jpcanesin/logitech-g613-keycaps/keys/017_R2_Grave.FCStd

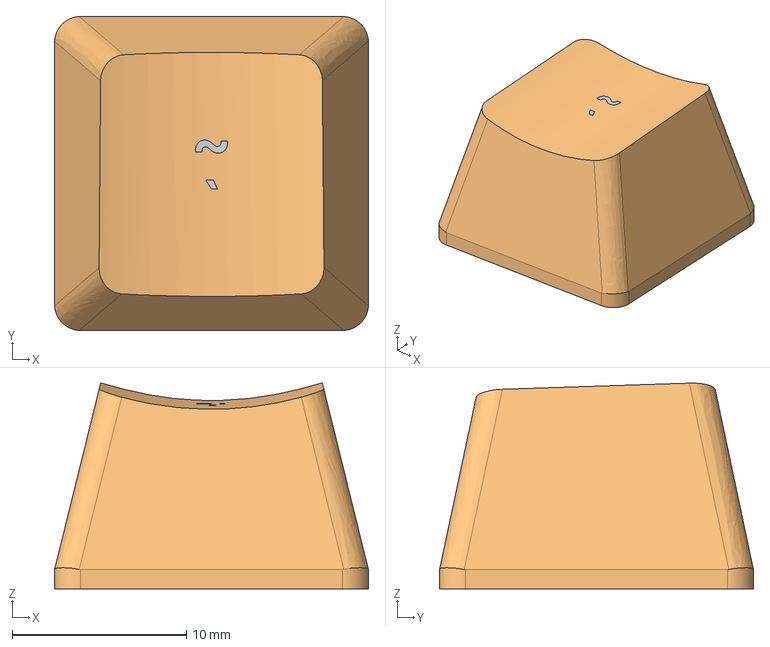
[picture p3: CAD file, 2026-10-18]
keys/017_R2_Grave.FCStd
18.0 x 18.0 x 11.8 mm
Inlay
Cap
