jpcanesin/logitech-g613-keycaps/shapes/R6-2.FCStd

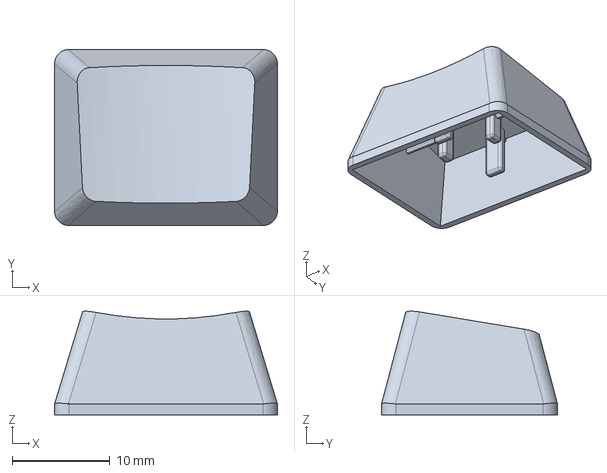
[picture p4: CAD file, 2026-10-18]
shapes/R6-2.FCStd
22.8 x 18.0 x 10.6 mm
