jpcanesin/logitech-g613-keycaps/keys/046_R3_I.FCStd

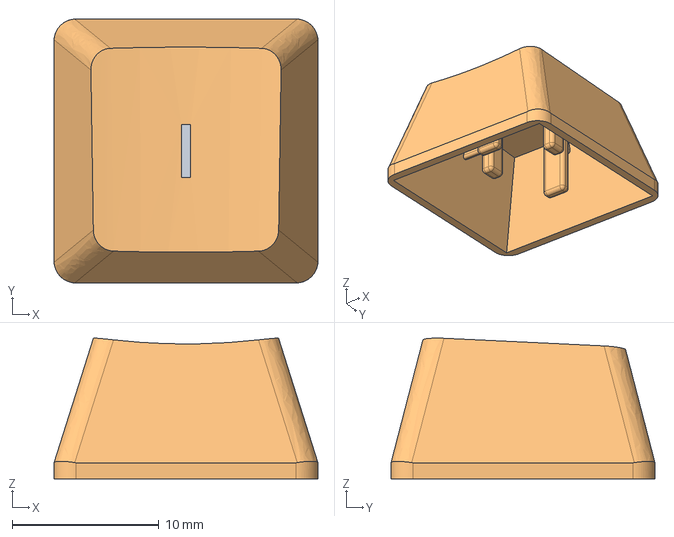
[picture p5: CAD file, 2026-10-18]
keys/046_R3_I.FCStd
18.0 x 18.0 x 9.60 mm
Inlay
Cap
