jpcanesin/logitech-g613-keycaps/shapes/NP-5.FCStd

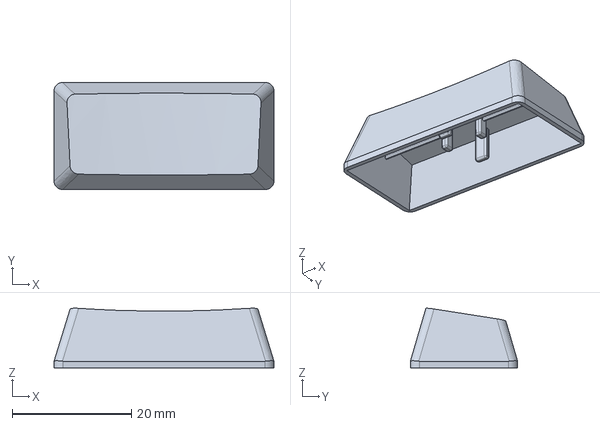
[picture p6: CAD file, 2026-10-18]
shapes/NP-5.FCStd
36.9 x 18.0 x 10.00 mm
