jpcanesin/logitech-g613-keycaps/shapes/NP-6.FCStd

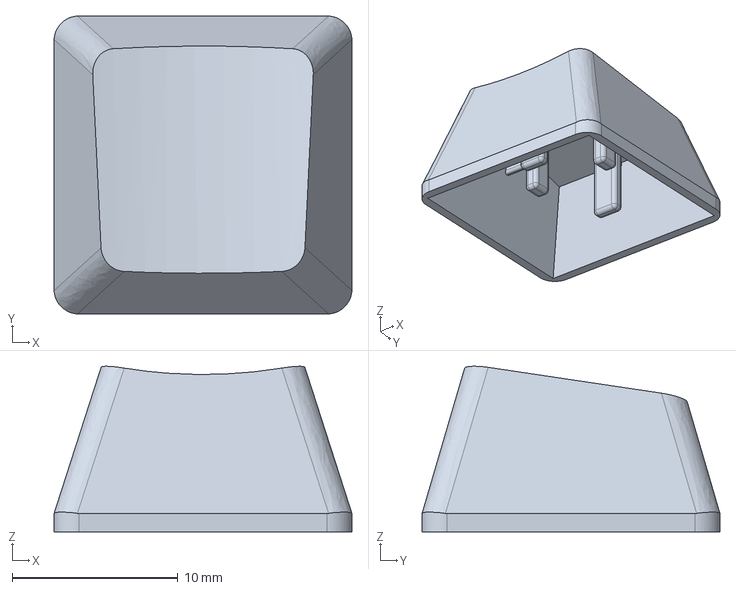
[picture p7: CAD file, 2026-10-18]
shapes/NP-6.FCStd
18.0 x 18.0 x 10.00 mm
