jpcanesin/logitech-g613-keycaps/shapes/R4-5.FCStd

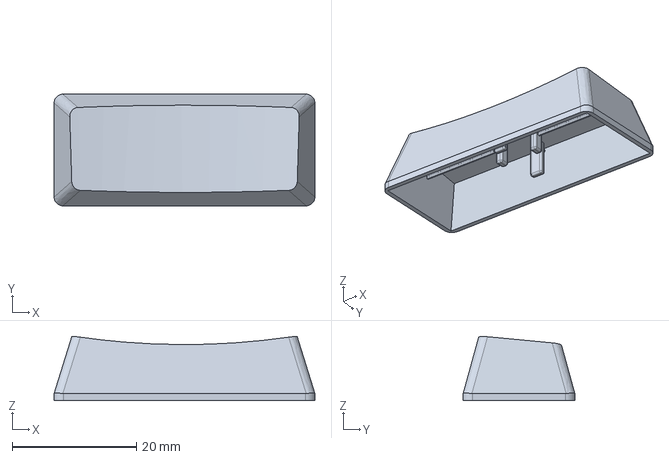
[picture p8: CAD file, 2026-10-18]
shapes/R4-5.FCStd
42.0 x 18.0 x 10.3 mm
