jpcanesin/logitech-g613-keycaps/keys/016_R1_Pause.FCStd

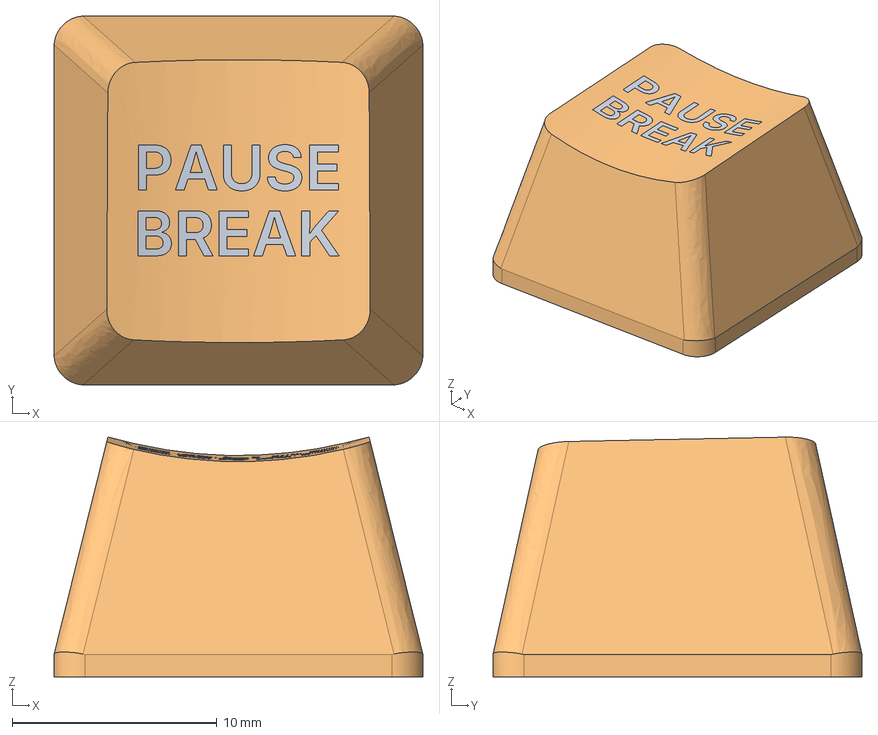
[picture p9: CAD file, 2026-10-18]
keys/016_R1_Pause.FCStd
18.0 x 18.0 x 11.7 mm
Inlay
Cap
