jpcanesin/logitech-g613-keycaps/keys/102_R6_ArrowRight.FCStd

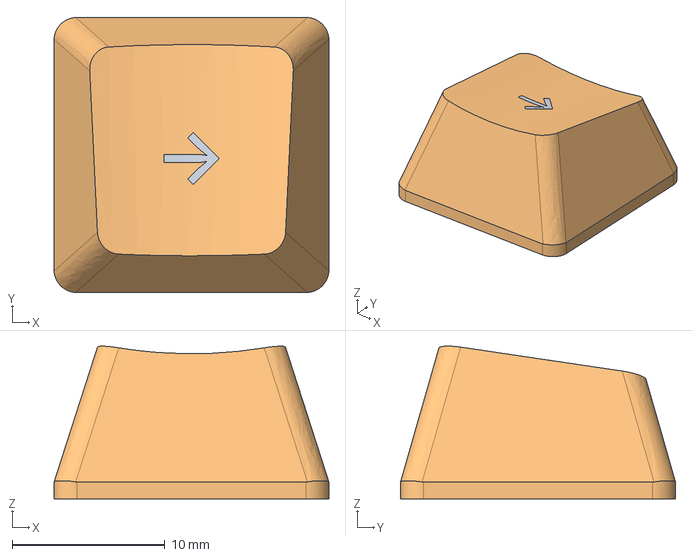
[picture p10: CAD file, 2026-10-18]
keys/102_R6_ArrowRight.FCStd
18.0 x 18.0 x 10.00 mm
Inlay
Cap
