jpcanesin/logitech-g613-keycaps/keys/097_R6_WinRight.FCStd

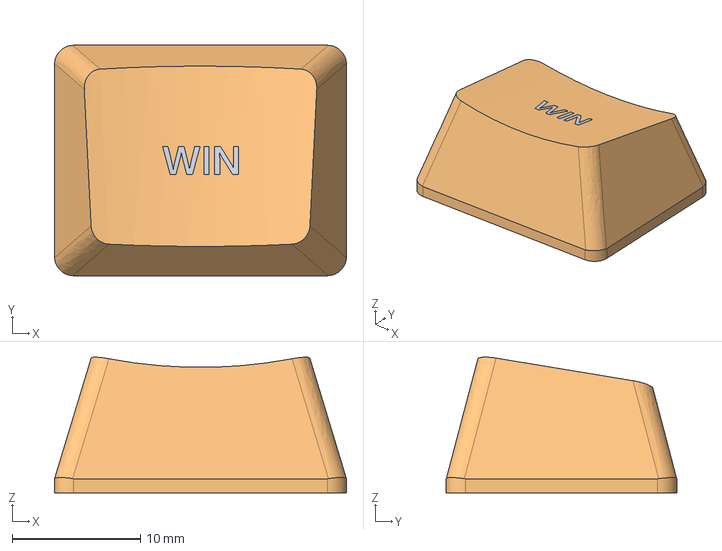
[picture p11: CAD file, 2026-10-18]
keys/097_R6_WinRight.FCStd
22.8 x 18.0 x 10.6 mm
Inlay
Cap
