jpcanesin/logitech-g613-keycaps/shapes/R6-1.FCStd

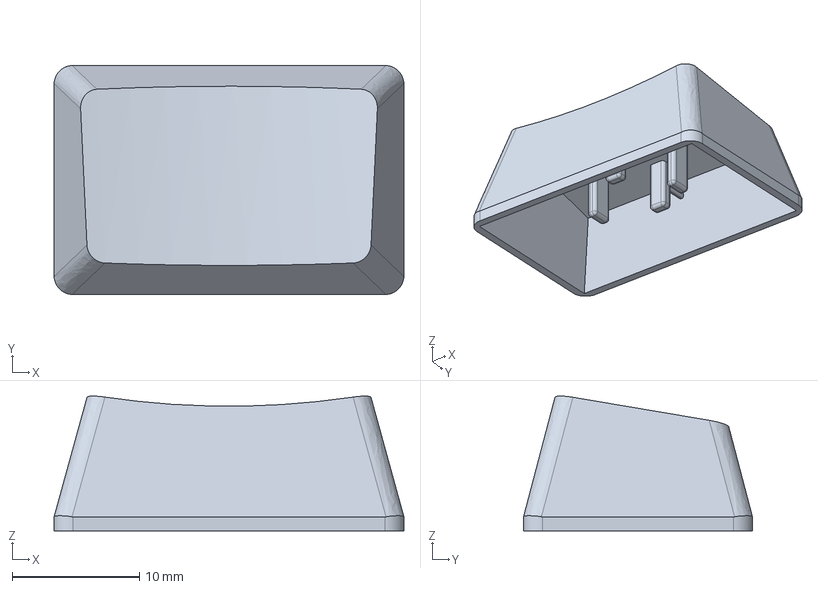
[picture p12: CAD file, 2026-10-18]
shapes/R6-1.FCStd
27.5 x 18.0 x 10.6 mm
