jpcanesin/logitech-g613-keycaps/shapes/R5-4.FCStd

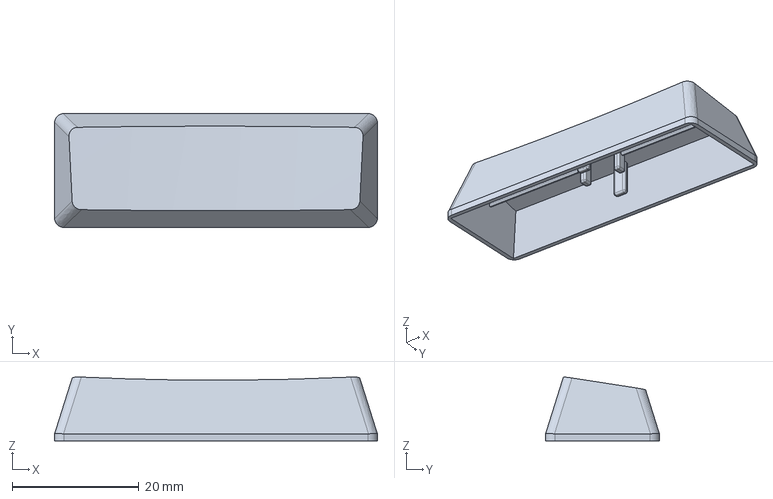
[picture p13: CAD file, 2026-10-18]
shapes/R5-4.FCStd
51.0 x 18.0 x 10.1 mm
