jpcanesin/logitech-g613-keycaps/keys/038_R3_Tab.FCStd

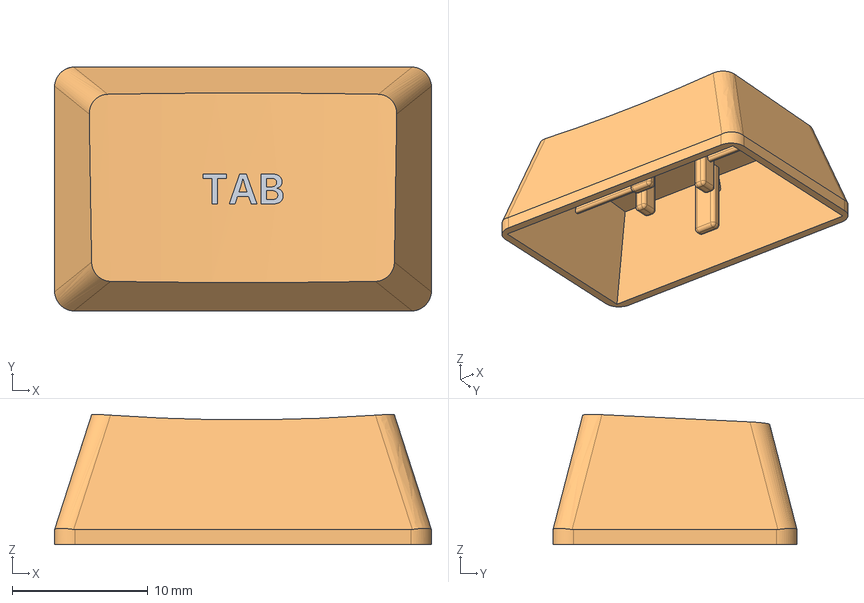
[picture p14: CAD file, 2026-10-18]
keys/038_R3_Tab.FCStd
27.8 x 18.0 x 9.60 mm
Inlay
Cap
