jpcanesin/logitech-g613-keycaps/shapes/R4-4.FCStd

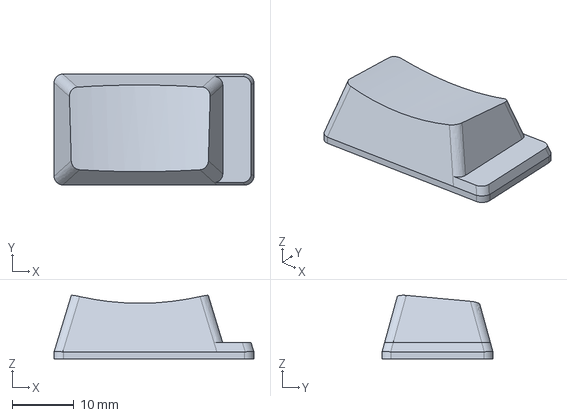
[picture p15: CAD file, 2026-10-18]
shapes/R4-4.FCStd
32.4 x 18.0 x 10.3 mm
