jpcanesin/logitech-g613-keycaps/keys/030_R2_Backspace.FCStd

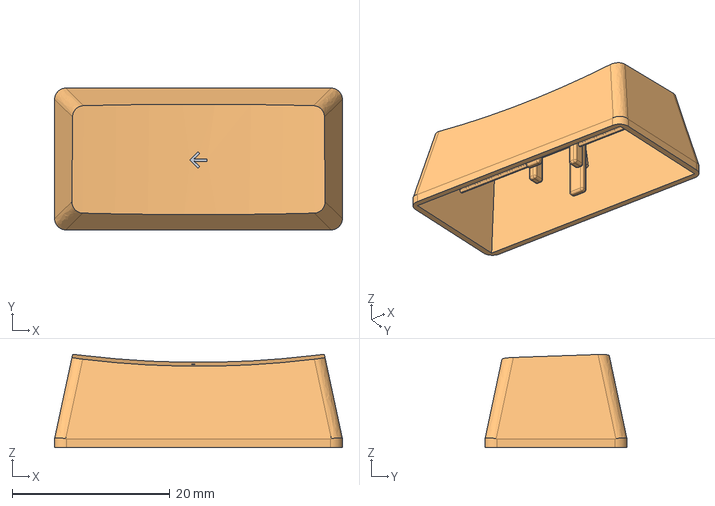
[picture p16: CAD file, 2026-10-18]
keys/030_R2_Backspace.FCStd
36.5 x 18.0 x 11.8 mm
Inlay
Cap
