jpcanesin/logitech-g613-keycaps/shapes/R6-4.FCStd

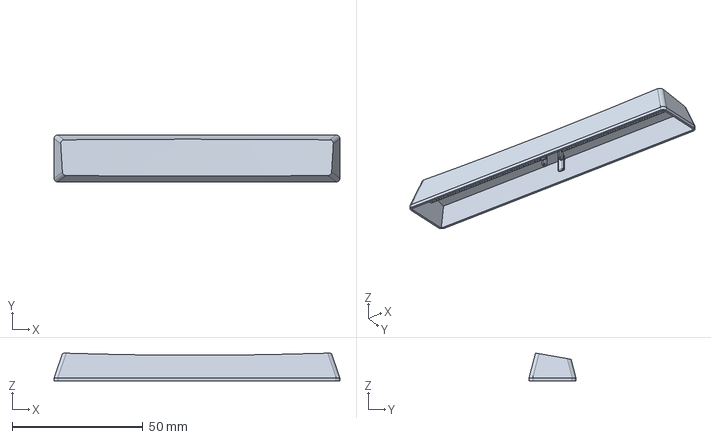
[picture p17: CAD file, 2026-10-18]
shapes/R6-4.FCStd
109.3 x 18.0 x 10.6 mm
