jpcanesin/logitech-g613-keycaps/shapes/NP-7.FCStd

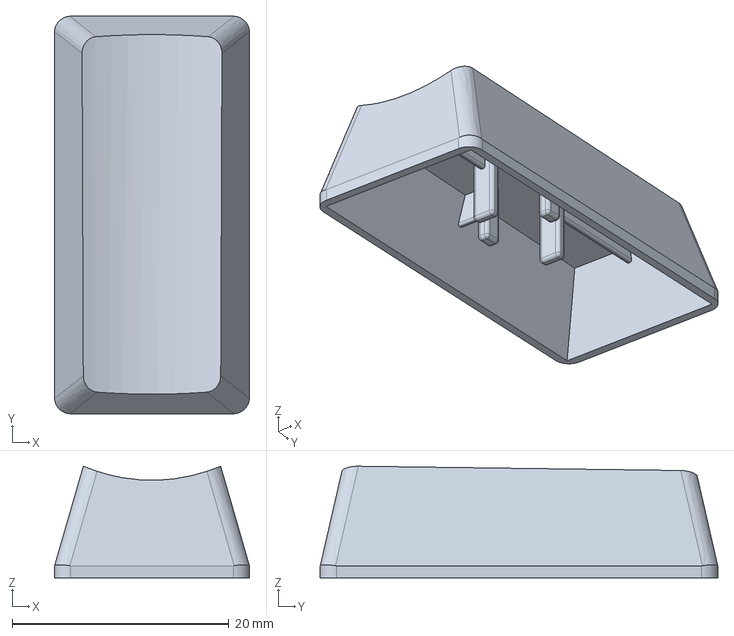
[picture p18: CAD file, 2026-10-18]
shapes/NP-7.FCStd
18.0 x 36.7 x 10.3 mm
