jpcanesin/logitech-g613-keycaps/keys/092_R6_CtrlLeft.FCStd

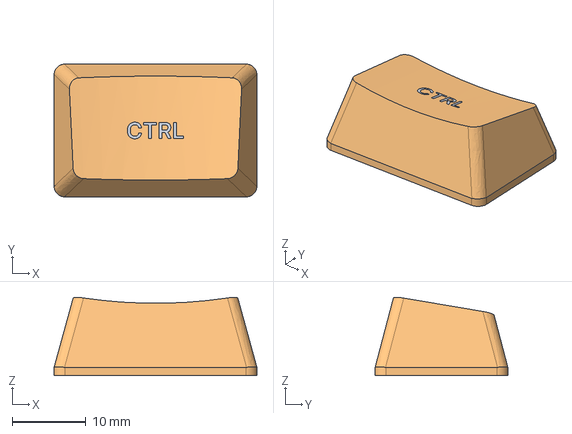
[picture p19: CAD file, 2026-10-18]
keys/092_R6_CtrlLeft.FCStd
27.5 x 18.0 x 10.6 mm
Inlay
Cap
