jpcanesin/logitech-g613-keycaps/keys/075_R5_ShiftLeft.FCStd

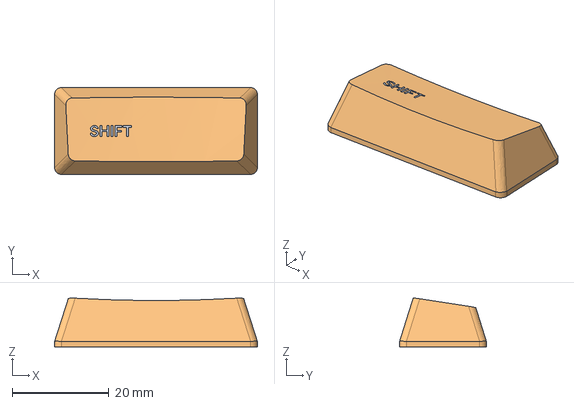
[picture p20: CAD file, 2026-10-18]
keys/075_R5_ShiftLeft.FCStd
42.0 x 18.0 x 10.1 mm
Inlay
Cap
