jpcanesin/logitech-g613-keycaps/keys/054_R3_PageDown.FCStd

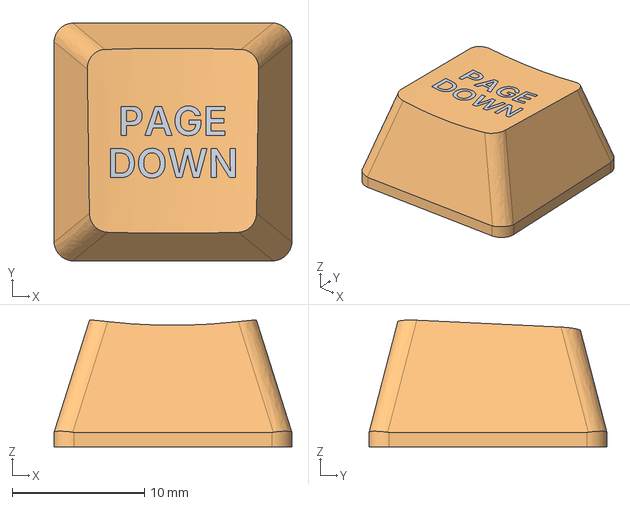
[picture p21: CAD file, 2026-10-18]
keys/054_R3_PageDown.FCStd
18.0 x 18.0 x 9.60 mm
Inlay
Cap
