jpcanesin/logitech-g613-keycaps/keys/059_R4_CapsLock.FCStd

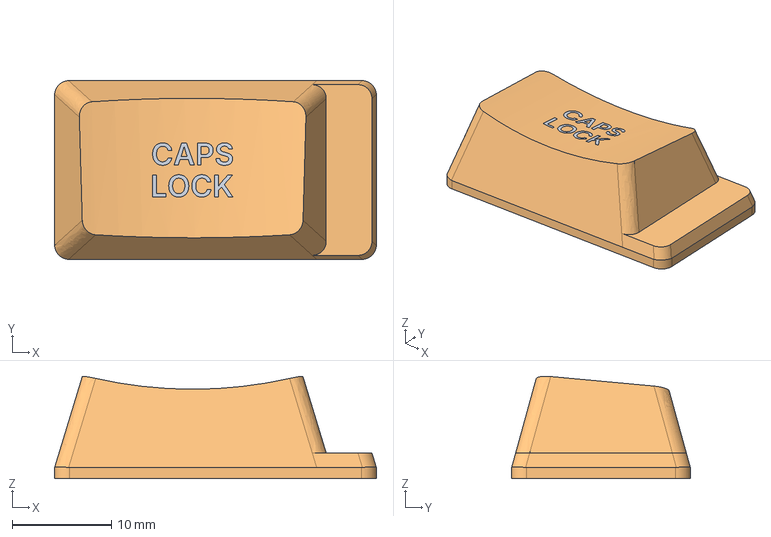
[picture p22: CAD file, 2026-10-18]
keys/059_R4_CapsLock.FCStd
32.4 x 18.0 x 10.3 mm
Inlay
Cap
