jpcanesin/logitech-g613-keycaps/keys/086_R5_ShiftRight.FCStd

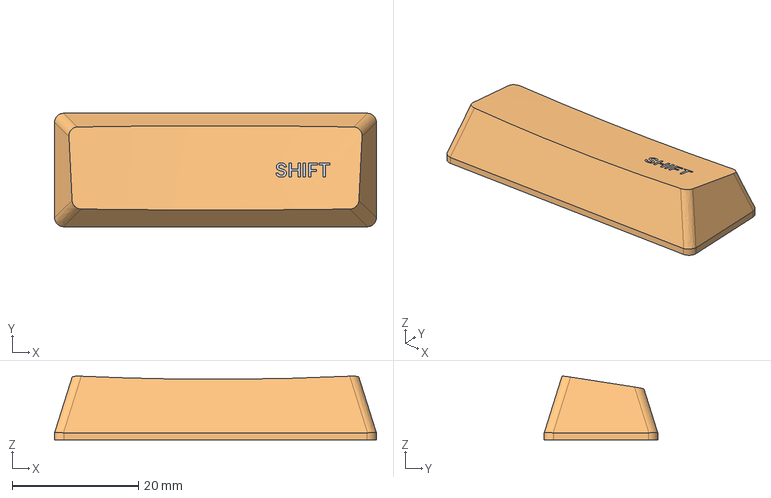
[picture p23: CAD file, 2026-10-18]
keys/086_R5_ShiftRight.FCStd
51.0 x 18.0 x 10.1 mm
Inlay
Cap
