jpcanesin/logitech-g613-keycaps/(list of files, cad)

Other CAD files:
keyboard.FCStd
set.FCStd
keys/009_R1_F8.FCStd
shapes/R1-1.FCStd
keys/029_R2_Equal.FCStd
keys/103_R6_Num0.FCStd
shapes/NP-8.FCStd
keys/041_R3_E.FCStd
shapes/R3-1.FCStd
shapes/R4-1.FCStd
keys/048_R3_P.FCStd
shapes/NAV-3.FCStd
keys/060_R4_A.FCStd
shapes/NAV-4.FCStd
keys/019_R2_2.FCStd
keys/034_R2_NumLock.FCStd
shapes/R5-3.FCStd
keys/068_R4_L.FCStd
shapes/R2-1.FCStd
keys/072_R4_Num4.FCStd
shapes/R5-1.FCStd
keys/089_R5_Num2.FCStd
keys/093_R6_WinLeft.FCStd
shapes/R3-3.FCStd
keys/076_R5_Z.FCStd
shapes/R2-4.FCStd
keys/007_R1_F6.FCStd
keys/023_R2_6.FCStd
keys/078_R5_C.FCStd
keys/065_R4_H.FCStd
keys/096_R6_AltRight.FCStd
keys/006_R1_F5.FCStd
keys/044_R3_Y.FCStd
keys/058_R3_NumPlus.FCStd
keys/027_R2_0.FCStd
keys/056_R3_Num8.FCStd
keys/032_R2_Home.FCStd
keys/052_R3_Delete.FCStd
keys/055_R3_Num7.FCStd
keys/094_R6_AltLeft.FCStd
keys/083_R5_Comma.FCStd
keys/080_R5_B.FCStd
keys/081_R5_N.FCStd
keys/073_R4_Num5.FCStd
keys/018_R2_1.FCStd
keys/104_R6_NumDecimal.FCStd
keys/088_R5_Num1.FCStd
keys/077_R5_X.FCStd
keys/015_R1_ScrollLock.FCStd
keys/082_R5_M.FCStd
keys/062_R4_D.FCStd
keys/043_R3_T.FCStd
keys/066_R4_J.FCStd
keys/010_R1_F9.FCStd
keys/108_R4_G4.FCStd
keys/047_R3_O.FCStd
keys/020_R2_3.FCStd
keys/084_R5_Period.FCStd
keys/063_R4_F.FCStd
keys/005_R1_F4.FCStd
keys/100_R6_ArrowLeft.FCStd
keys/012_R1_F11.FCStd
keys/049_R3_BracketLeft.FCStd
keys/079_R5_V.FCStd
keys/013_R1_F12.FCStd
keys/061_R4_S.FCStd
keys/022_R2_5.FCStd
keys/105_R1_G1.FCStd
keys/028_R2_Minus.FCStd
keys/045_R3_U.FCStd
keys/021_R2_4.FCStd
keys/039_R3_Q.FCStd
keys/050_R3_BracketRight.FCStd
keys/051_R3_Backslash.FCStd
keys/036_R2_NumAsterisk.FCStd
keys/098_R6_Menu.FCStd
keys/101_R6_ArrowDown.FCStd
keys/095_R6_Space.FCStd
keys/109_R5_G5.FCStd
keys/003_R1_F2.FCStd
keys/069_R4_Semicolon.FCStd
keys/107_R3_G3.FCStd
keys/011_R1_F10.FCStd
keys/042_R3_R.FCStd
keys/040_R3_W.FCStd
keys/026_R2_9.FCStd
keys/070_R4_Quote.FCStd
keys/008_R1_F7.FCStd
keys/037_R2_NumMinus.FCStd
keys/087_R5_ArrowUp.FCStd
keys/110_R6_G6.FCStd
keys/099_R6_CtrlRight.FCStd
keys/035_R2_NumSlash.FCStd
keys/106_R2_G2.FCStd
keys/033_R2_PageUp.FCStd
keys/024_R2_7.FCStd
keys/004_R1_F3.FCStd
keys/002_R1_F1.FCStd
keys/064_R4_G.FCStd
keys/014_R1_PrintScreen.FCStd
keys/057_R3_Num9.FCStd
keys/053_R3_End.FCStd
keys/067_R4_K.FCStd
keys/091_R5_NumEnter.FCStd
keys/001_R1_Esc.FCStd
keys/025_R2_8.FCStd
keys/071_R4_Enter.FCStd
keys/031_R2_Insert.FCStd
keys/090_R5_Num3.FCStd
keys/074_R4_Num6.FCStd
keys/085_R5_Slash.FCStd
