jpcanesin/logitech-g613-keycaps/(commit log)

2026-10-18 Script-built parametric keycap set
    keycap.py generates each keycap from parameters; fit_profile.py fits them
    to caliper measurements; build_keyboard.py builds all shapes, the STLs
    (not versioned, regenerable) and keyboard.FCStd linking every key.
    [NAV-3.FCStd, NAV-4.FCStd, NP-5.FCStd, NP-6.FCStd, NP-7.FCStd, NP-8.FCStd, R1-1.FCStd, R2-1.FCStd]
2026-10-18 Native parametric FreeCAD keycaps
    build_native.py writes set.FCStd (set-wide spreadsheet), one
    expression-driven model per shape in shapes/ (Params spreadsheet,
    Draft lofts, dish cylinder, PartDesign stems/ribs) and keyboard.FCStd
    linking all keys. Editing a cell and recomputing rebuilds the key; no
    Python needed to use the files. The dish is parameterized by dish_sag,
    which maps exactly to the fitted radius. All 20 shapes match the
    script-built geometry (max volume difference 0.003 mm3).
    build_keyboard.py now only fits and exports STLs.
    [NAV-3.FCStd, NAV-4.FCStd, NP-5.FCStd, NP-6.FCStd, NP-7.FCStd, NP-8.FCStd, R1-1.FCStd, R2-1.FCStd]
2026-10-18 Make the native FreeCAD model the only geometry
    fit_profile.py now fits measurements by editing a native shape's Params
    and recomputing, and fits dish_sag straight from the caliper dish depth.
    build_native.py reads the CSVs, writes set.FCStd, fits (cached in
    fitted_shapes.csv), and builds shapes/ and keyboard.FCStd.
    export_stl.py meshes every key from the FreeCAD files, so STLs follow
    edits made in FreeCAD. keycap.py and build_keyboard.py are removed
    (kept in tag script-v1).
    [NAV-3.FCStd, NAV-4.FCStd, NP-5.FCStd, NP-6.FCStd, NP-7.FCStd, NP-8.FCStd, R1-1.FCStd, R2-1.FCStd]
2026-10-18 Model Caps Lock as a stepped key
    Shapes gain body_w (raised part's base length, flush left) and
    step_height. Stepped shapes add a hollow full-footprint shelf up to
    step_height; the dish, cavity, stems and ribs follow the raised part.
    keys_to_measure.csv gets optional step_body_length_mm/step_height_mm
    columns; Caps Lock is a Tab-like raised part (27.8 base, 22.5 top) with
    the ASD row profile and a 2.6 mm shelf. The fit measures at the raised
    part's middle.
    [NAV-3.FCStd, NAV-4.FCStd, NP-5.FCStd, NP-6.FCStd, NP-7.FCStd, NP-8.FCStd, R1-1.FCStd, R2-1.FCStd]
2026-10-18 Add two-colour legend inlays
    legends.csv gives every key one or two lines of text, an alignment
    (center, or a fixed margin from the left/right/front edge) and a cap
    height. build_native.py writes one keys/NNN_<row>_<key>.FCStd per key:
    its shape's Keycap linked, a Legend sheet, ShapeString text extruded
    and kept within legend_depth below the dish, giving Cap (with recess)
    and Inlay. Font, size, line gap and depth live in set.FCStd; the font
    is Inter SemiBold (OFL) in fonts/. keyboard.FCStd links every Cap and
    Inlay; export_stl.py writes a cap and a legend STL per key.
    Also rebuild fitted_shapes.csv from the shape files: a row had been
    corrupted by an unclosed write in the previous change.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
    [001_R1_Esc.FCStd, 002_R1_F1.FCStd, 003_R1_F2.FCStd, 004_R1_F3.FCStd, 005_R1_F4.FCStd, 006_R1_F5.FCStd, 007_R1_F6.FCStd, 008_R1_F7.FCStd]
2026-10-18 Apply legend edits and rename the Fn key to Menu
    Legends follow the edited legends.csv (uppercase words, stacked
    two-word legends, 5 mm margins on the aligned keys). The key right of
    the right Win is the Menu (context menu) key, not Fn.
    [001_R1_Esc.FCStd, 002_R1_F1.FCStd, 003_R1_F2.FCStd, 004_R1_F3.FCStd, 005_R1_F4.FCStd, 006_R1_F5.FCStd, 007_R1_F6.FCStd, 008_R1_F7.FCStd]
2026-10-18 Add the G1-G6 macro keys
    The G-keys reuse the measured shape of the key in their row (G1 Esc,
    G2 Grave, G3 Q, G4 A, G5 Z, G6 Down arrow) and sit in a column 0.5u
    left of the main block, with G1-G6 legends. README and images updated.
    [001_R1_Esc.FCStd, 002_R1_F1.FCStd, 003_R1_F2.FCStd, 004_R1_F3.FCStd, 005_R1_F4.FCStd, 006_R1_F5.FCStd, 007_R1_F6.FCStd, 008_R1_F7.FCStd]
2026-10-18 Resolve the legend font relative to the repository; document STL download
    set.FCStd gets font_name (relative, e.g. fonts/Inter-SemiBold.ttf) and
    derives font_file from its own file location, so the font resolves in
    any clone. export_stl.py re-evaluates each key's Legend sheet so font
    changes reach every key. README links the STL zip on the latest
    release and explains how to generate the STLs.
    [001_R1_Esc.FCStd, 002_R1_F1.FCStd, 003_R1_F2.FCStd, 004_R1_F3.FCStd, 005_R1_F4.FCStd, 006_R1_F5.FCStd, 007_R1_F6.FCStd, 008_R1_F7.FCStd]
